douglasnavarro/rede-de-sensores/README.md

# rede-de-sensores
Rede de sensores de presença

Confira uma apresentação em [vídeo do projeto](https://www.youtube.com/watch?v=fuPidej-O7c&t=0s&list=PLMp4nLC2kXhuEHrjNnDw4fBF1sRVGfNI7&index=10).
