douglasnavarro/rede-de-sensores/eagle/Sensor de Presença.pdf

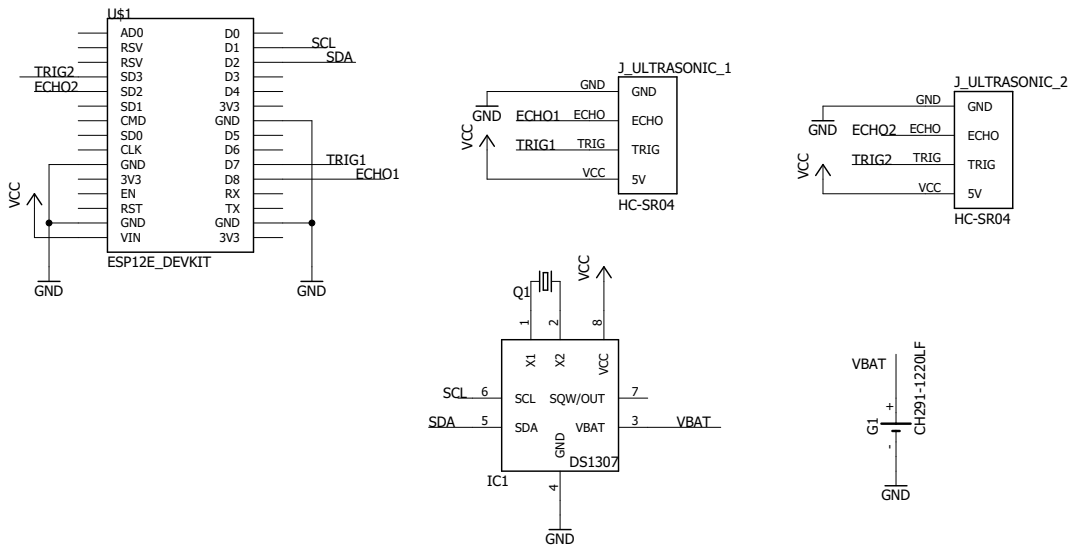
[picture p35: page 1]
