douglasnavarro/rede-de-sensores/eagle/Sensor de Presença.brd

## EAGLE design eagle/Sensor de Presença.brd (2017-12-17)

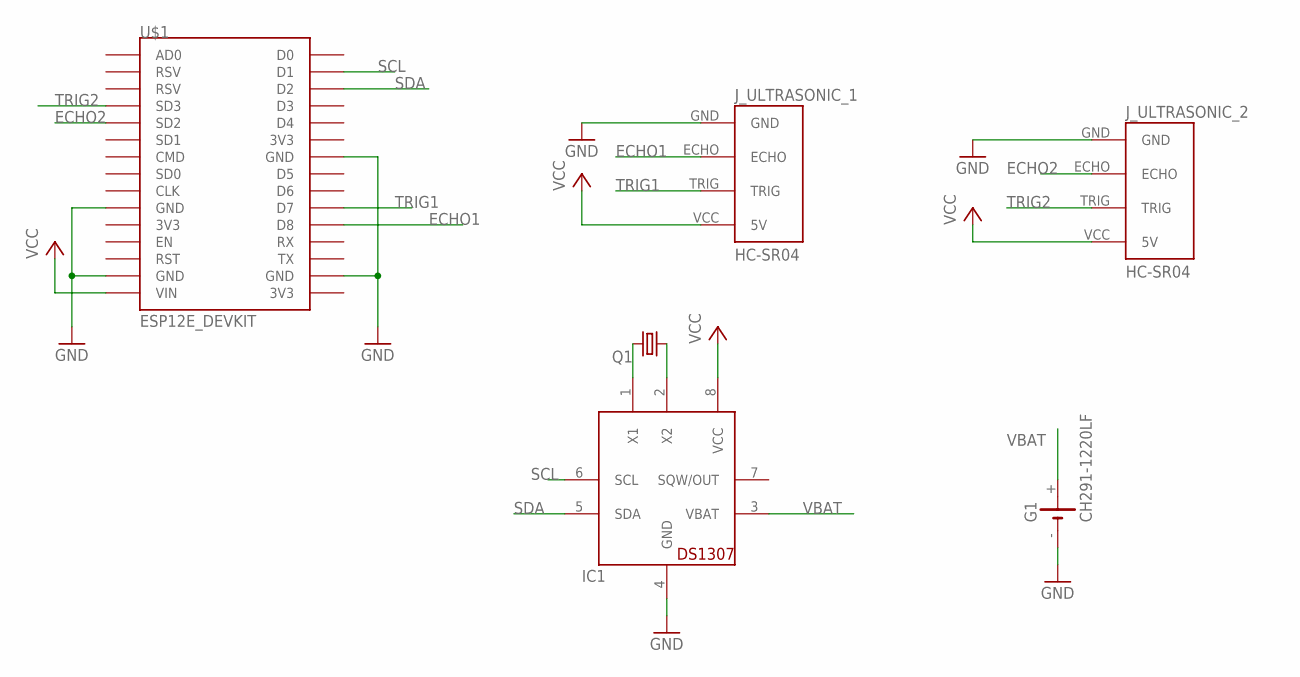
[picture p36: schematic Sensor de Presença.sch]

Parts:
G1: CH291-1220LF
IC1: DS1307; DIL08
J_ULTRASONIC_1, J_ULTRASONIC_2: HC-SR04; HC-SR04_FOOTPRINT
Q1: CRYSTALTC38H; TC38H
U$1: ESP12E_DEVKIT

Connections:
ECHO1: J_ULTRASONIC_1.ECHO, U$1.D8
ECHO2: J_ULTRASONIC_2.ECHO, U$1.SD2
GND: G1.-, IC1.4 (GND), J_ULTRASONIC_1.GND, J_ULTRASONIC_2.GND, U$1.GND@0 (GND), U$1.GND@1 (GND), U$1.GND@2 (GND), U$1.GND@3 (GND)
unnamed: IC1.1 (X1), Q1.2
unnamed: IC1.2 (X2), Q1.1
SCL: IC1.6 (SCL), U$1.D1
SDA: IC1.5 (SDA), U$1.D2
TRIG1: J_ULTRASONIC_1.TRIG, U$1.D7
TRIG2: J_ULTRASONIC_2.TRIG, U$1.SD3
VBAT: G1.+, IC1.3 (VBAT)
VCC: IC1.8 (VCC), J_ULTRASONIC_1.VCC (5V), J_ULTRASONIC_2.VCC (5V), U$1.VIN

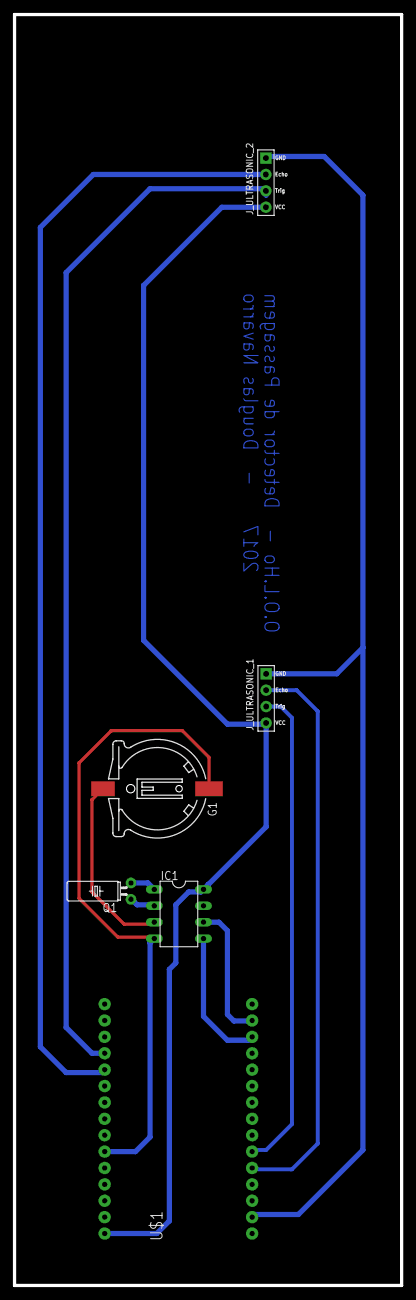
[picture p37: board Sensor de Presença.brd from above]

Board: 2 copper layers, 60.0 x 197.0 mm, 6 parts (0 on the bottom side), 11 nets.
