douglasnavarro/rede-de-sensores/(commit log)

2017-09-02 added eagle .sch rev 1.0
    [Sensor de Presença.brd, Sensor de Presença.sch]
2017-11-25 updated eagle project to include 2 ultrassonic sensors and ds1307 rtc
    [Sensor de Presença.brd, Sensor de Presença.sch]
2017-12-17 added final prototype pcb layout and text
    [Sensor de Presença.brd, Sensor de Presença.sch]
